ciasduhnvuerueffh634549/PCB-TESI-ODINO/PCB/distinta PCB v3-TESI.xlsx

Riferimento | Qtà | Descrizione | Package | Produttore | MPN (Part Number) | Mouser Part Number
U5 | 1 | ADC 16-Bit Bipolare (SAR) | LQFP-64 | Analog Devices | AD7606BSTZ | 584-AD7606BSTZ
U6, U11, U12, U13 | 4 | Quad Op-Amp (250 MHz) | SSOP-16 | Texas Instruments | OPA4350EA/250 | 595-OPA4350EA/250
U1 | 1 | DC/DC Invertente | TSOT-23-6 | Analog Devices | LT3483AES6#TRMPBF | 584-LT3483AES6TRMPBF
U2 | 1 | LDO +2.5V (100mA) | TSOT-23-5 | Analog Devices | LT1761ES5-2.5#TRMPBF | 584-LT1761ES5-2.5TRM
U3 | 1 | LDO Negativo | TSOT-23-5 | Analog Devices | LT1964ES5-BYP#TRMPBF | 584-LT1964ES5-BYPTRM
D1 | 1 | Diodo Schottky 30V 0.5A | SOD-323 | Diodes Inc. | BAT760-7 | 621-BAT760-7
D2, D3 | 2 | LED SMD Verde | 603 | Würth Elektronik | 150060VS75000 | 710-150060VS75000
R3 | 1 | 511 kΩ, 0.1% | 603 | Yageo | RT0603BRD07511KL | 603-RT0603BRD07511KL
R4 | 1 | 105 kΩ, 0.1% | 603 | Yageo | RT0603BRD07105KL | 603-RT0603BRD07105KL
R5 | 1 | 100 kΩ, 0.1% | 603 | Yageo | RT0603BRD07100KL | 603-RT0603BRD07100KL
R7, R8 | 2 | 4.7 kΩ, 0.1% | 603 | Yageo | RT0603BRD074K7L | 603-RT0603BRD074K7L
R10, R22, R27, R32... | 8 | 1 MΩ, 0.1% | 603 | Yageo | RT0603BRD071ML | 603-RT0603BRD071ML
R23, R25, R28, R30... | 14 | 5 kΩ, 0.1% | 603 | Yageo | RT0603BRD075KL | 603-RT0603BRD075KL
R24, R26, R29, R31... | 14 | 10 kΩ, 0.1% | 603 | Yageo | RT0603BRD0710KL | 603-RT0603BRD0710KL
C1 | 1 | 4.7 µF, 10V, X7R | 805 | Murata | GRM21BR71A475KA73L | 81-GRM21BR71A475KA73
C3, C4, C42, C46, C47 | 5 | 10 µF, 10V, X7R | 805 | Murata | GRM21BR71A106KE51L | 81-GRM21BR71A106KE51
C45 | 1 | 1 µF, 25V, X7R | 805 | Murata | GRM21BR71E105KA99L | 81-GRM21BR71E105K99L
C11, C22, C23, C24... | 8 | 100 nF (0.1µF), 16V, X7R | 603 | Murata | GRM188R71C104KA01D | 81-GRM188R71C104KA01
C5 | 1 | 10 nF (0.01µF), 50V, X7R | 603 | Murata | GRM188R71H103KA01D | 81-GRM188R71H103KA01
C2 | 1 | 22 pF, 50V, C0G | 603 | Murata | GRM1885C1H220JA01D | 81-GRM1885C1H220JA01
C8, C10, C12, C13... | 8 | 15 pF, 50V, C0G | 603 | Murata | GRM1885C1H150JA01D | 81-GRM1885C1H150J01D
L1 | 1 | Induttore Accoppiato 4.7 µH | SMD | Eaton | SDQ12-4R7-R | 704-SDQ12-4R7-R
J3 | 1 | Connettore FPC 10-pin | SMD | Würth | 687110182122 | 710-687110182122
J1 | 1 | Pin Header 1x02 (SMD) | SMD | Samtec | TSM-102-01-L-SV | 200-TSM10201LSV
J5 | 1 | Pin Header 1x03 (SMD) | SMD | Samtec | TSM-103-01-L-SV | 200-TSM10301LSV
J7 | 1 | Pin Header 1x07 (SMD) | SMD | Samtec | TSM-107-01-L-SV | 200-TSM10701LSV
