ciasduhnvuerueffh634549/PCB-TESI-ODINO/PCB/PCB v2.kicad_pcb

## KiCad design PCB/PCB v2.kicad_pcb (2026-09-29)

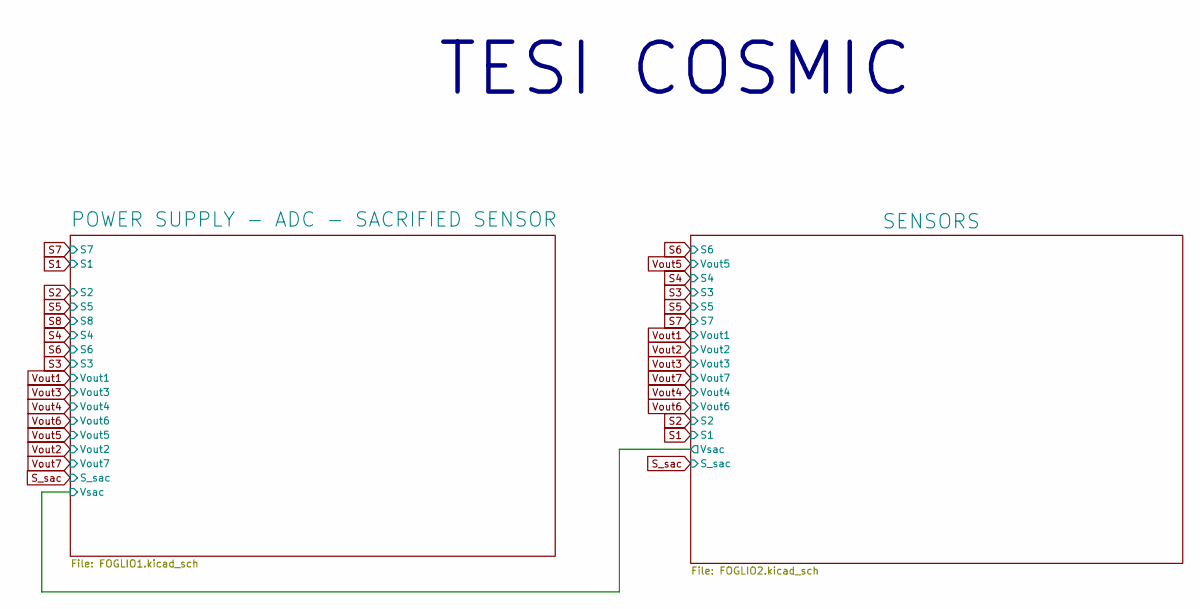
[picture p1: schematic PCB v2.kicad_sch, Tesi di laurea]

Notes on the sheet:
TESI COSMIC

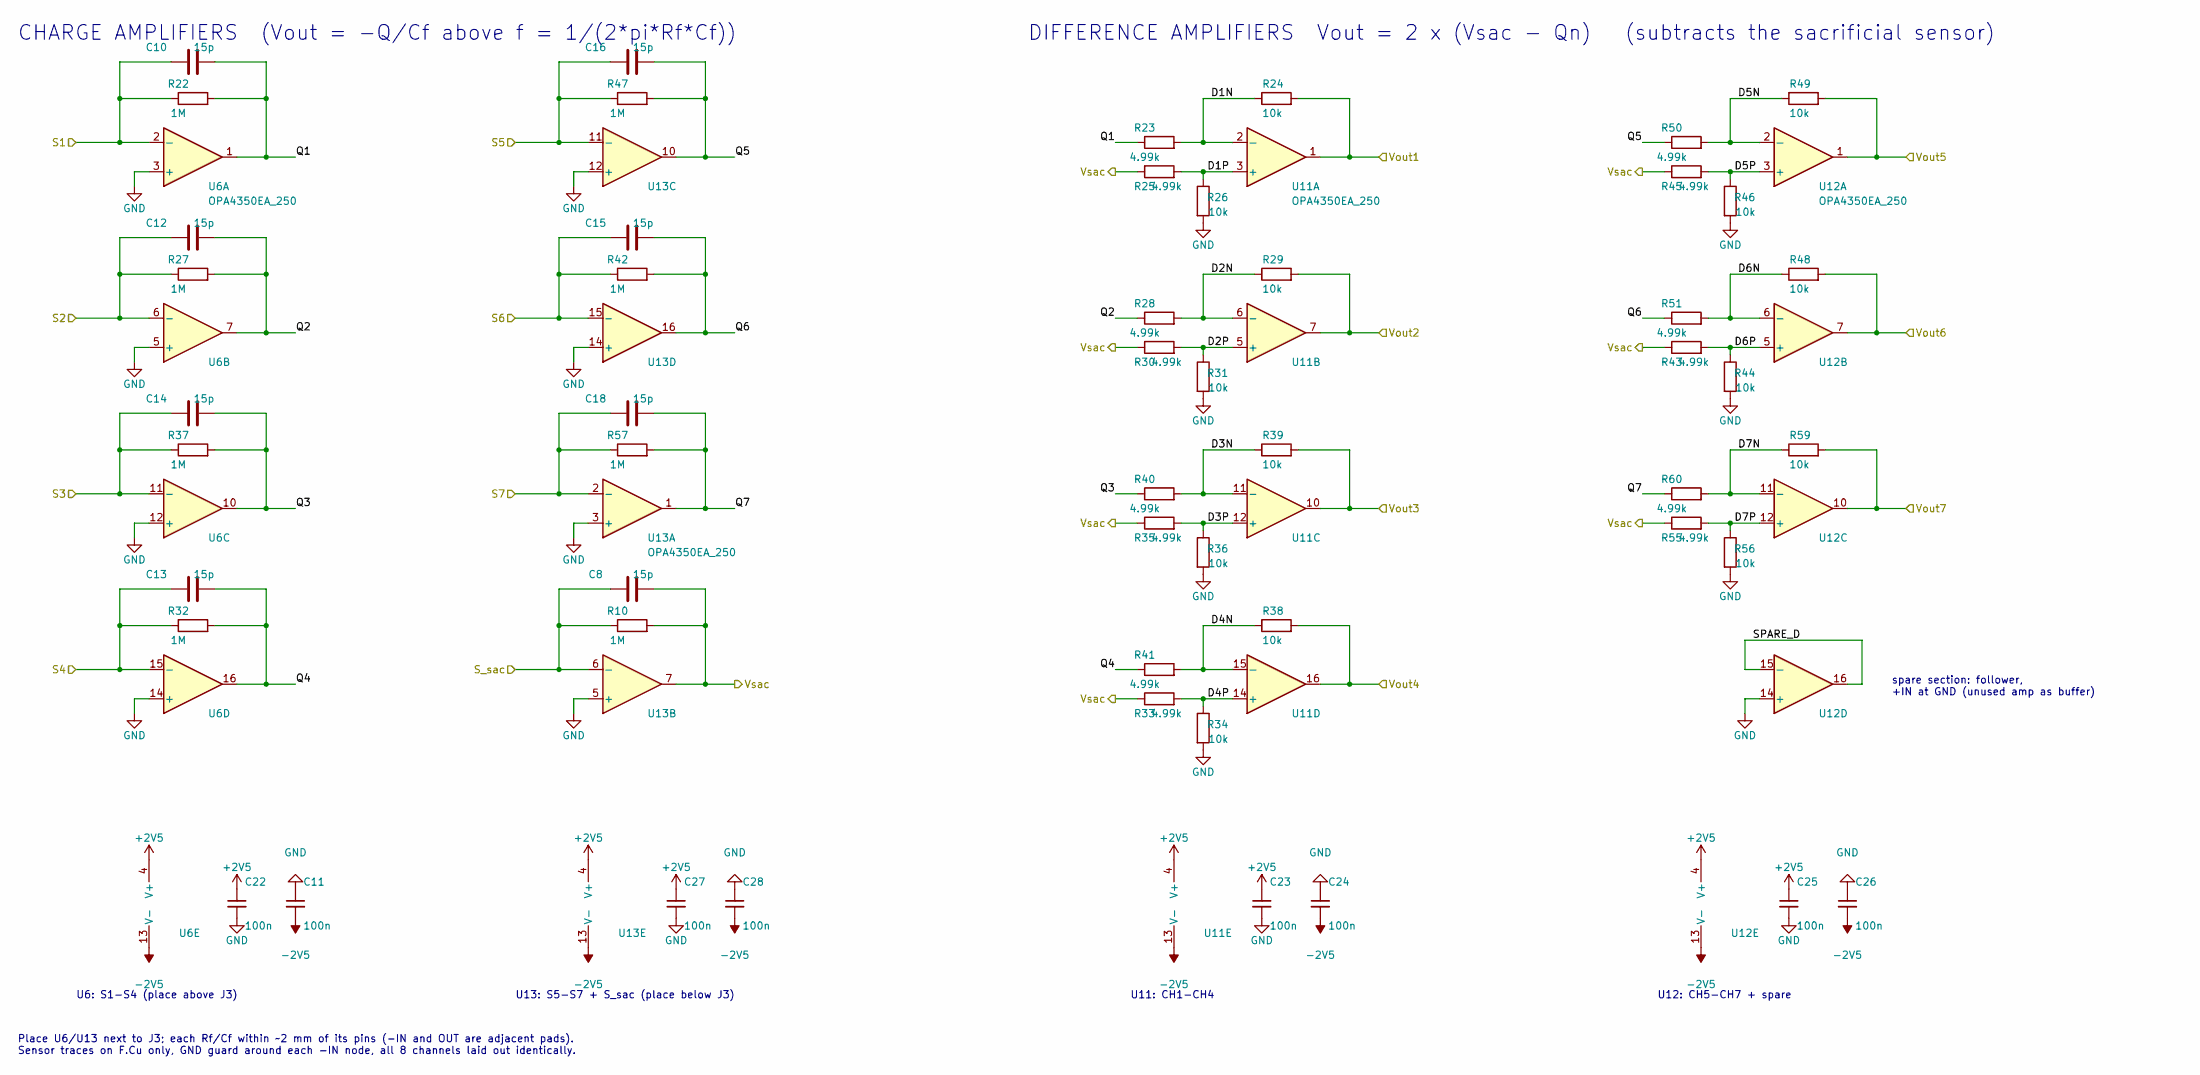
[picture p2: schematic FOGLIO2.kicad_sch]

Parts:
C8, C10, C12, C13, C14, C15, C16, C18: 15p; C_0603_1608Metric; MPN CL10C150JB8NNNC
C11, C22, C23, C24, C25, C26, C27, C28: 100n; C_0603_1608Metric; MPN GRM188R72A104KA35D
R10, R22, R27, R32, R37, R42, R47, R57: 1M; R_0603_1608Metric; MPN RN73R1JTTD1004B25
R23, R25, R28, R30, R33, R35, R40, R41, R43, R45, R50, R51, R55, R60: 4.99k; R_0603_1608Metric; MPN RT0603BRD074K99L
R24, R26, R29, R31, R34, R36, R38, R39, R44, R46, R48, R49, R56, R59: 10k; R_0603_1608Metric; MPN RT0603BRD0710KL
U6, U11, U12, U13: OPA4350EA_250; SOP63P600X175-16N; MPN OPA4350EA/250

Connections:
+2V5: C22.1, C23.1, C25.1, C27.1, U6.4 (V+), U11.4 (V+), U12.4 (V+), U13.4 (V+); also elsewhere on the board
-2V5: C11.2, C24.2, C26.2, C28.2, U6.13 (V-), U11.13 (V-), U12.13 (V-), U13.13 (V-); also elsewhere on the board
/POWER SUPPLY - ADC - SACRIFIED SENSOR/Vsac: C8.2, R10.2, R25.1, R30.1, R33.1, R35.1, R43.1, R45.1, R55.1, U13.7; also elsewhere on the board
/SENSORS/D1N: R23.2, R24.1, U11.2 (-)
/SENSORS/D1P: R25.2, R26.1, U11.3 (+)
/SENSORS/D2N: R28.2, R29.1, U11.6 (-)
/SENSORS/D2P: R30.2, R31.1, U11.5 (+)
/SENSORS/D3N: R39.1, R40.2, U11.11 (-)
/SENSORS/D3P: R35.2, R36.1, U11.12 (+)
/SENSORS/D4N: R38.1, R41.2, U11.15 (-)
/SENSORS/D4P: R33.2, R34.1, U11.14 (+)
/SENSORS/D5N: R49.1, R50.2, U12.2 (-)
/SENSORS/D5P: R45.2, R46.1, U12.3 (+)
/SENSORS/D6N: R48.1, R51.2, U12.6 (-)
/SENSORS/D6P: R43.2, R44.1, U12.5 (+)
/SENSORS/D7N: R59.1, R60.2, U12.11 (-)
/SENSORS/D7P: R55.2, R56.1, U12.12 (+)
/SENSORS/Q1: C10.2, R22.2, R23.1, U6.1
/SENSORS/Q2: C12.2, R27.2, R28.1, U6.7
/SENSORS/Q3: C14.2, R37.2, R40.1, U6.10
/SENSORS/Q4: C13.2, R32.2, R41.1, U6.16
/SENSORS/Q5: C16.2, R47.2, R50.1, U13.10
/SENSORS/Q6: C15.2, R42.2, R51.1, U13.16
/SENSORS/Q7: C18.2, R57.2, R60.1, U13.1
/SENSORS/SPARE_D: U12.15 (-), U12.16
GND: C11.1, C22.2, C23.2, C24.1, C25.2, C26.1, C27.2, C28.1, R26.2, R31.2, R34.2, R36.2, R44.2, R46.2, R56.2, U6.3 (+), U6.5 (+), U6.12 (+), U6.14 (+), U12.14 (+), U13.3 (+), U13.5 (+), U13.12 (+), U13.14 (+); also elsewhere on the board
S1: C10.1, R22.1, U6.2 (-); also elsewhere on the board
S2: C12.1, R27.1, U6.6 (-); also elsewhere on the board
S3: C14.1, R37.1, U6.11 (-); also elsewhere on the board
S4: C13.1, R32.1, U6.15 (-); also elsewhere on the board
S5: C16.1, R47.1, U13.11 (-); also elsewhere on the board
S6: C15.1, R42.1, U13.15 (-); also elsewhere on the board
S7: C18.1, R57.1, U13.2 (-); also elsewhere on the board
S_sac: C8.1, R10.1, U13.6 (-); also elsewhere on the board
Vout1: R24.2, U11.1; also elsewhere on the board
Vout2: R29.2, U11.7; also elsewhere on the board
Vout3: R39.2, U11.10; also elsewhere on the board
Vout4: R38.2, U11.16; also elsewhere on the board
Vout5: R49.2, U12.1; also elsewhere on the board
Vout6: R48.2, U12.7; also elsewhere on the board
Vout7: R59.2, U12.10; also elsewhere on the board

Notes on the sheet:
Place U6/U13 next to J3; each Rf/Cf within ~2 mm of its pins (-IN and OUT are adjacent pads). Sensor traces on F.Cu only, GND guard around each -IN node, all 8 channels laid out identically.
U12: CH5-CH7 + spare
U13: S5-S7 + S_sac (place below J3)
CHARGE AMPLIFIERS (Vout = -Q/Cf above f = 1/(2*pi*Rf*Cf))
spare section: follower, +IN at GND (unused amp as buffer)
U6: S1-S4 (place above J3)
U11: CH1-CH4
DIFFERENCE AMPLIFIERS Vout = 2 x (Vsac - Qn) (subtracts the sacrificial sensor)

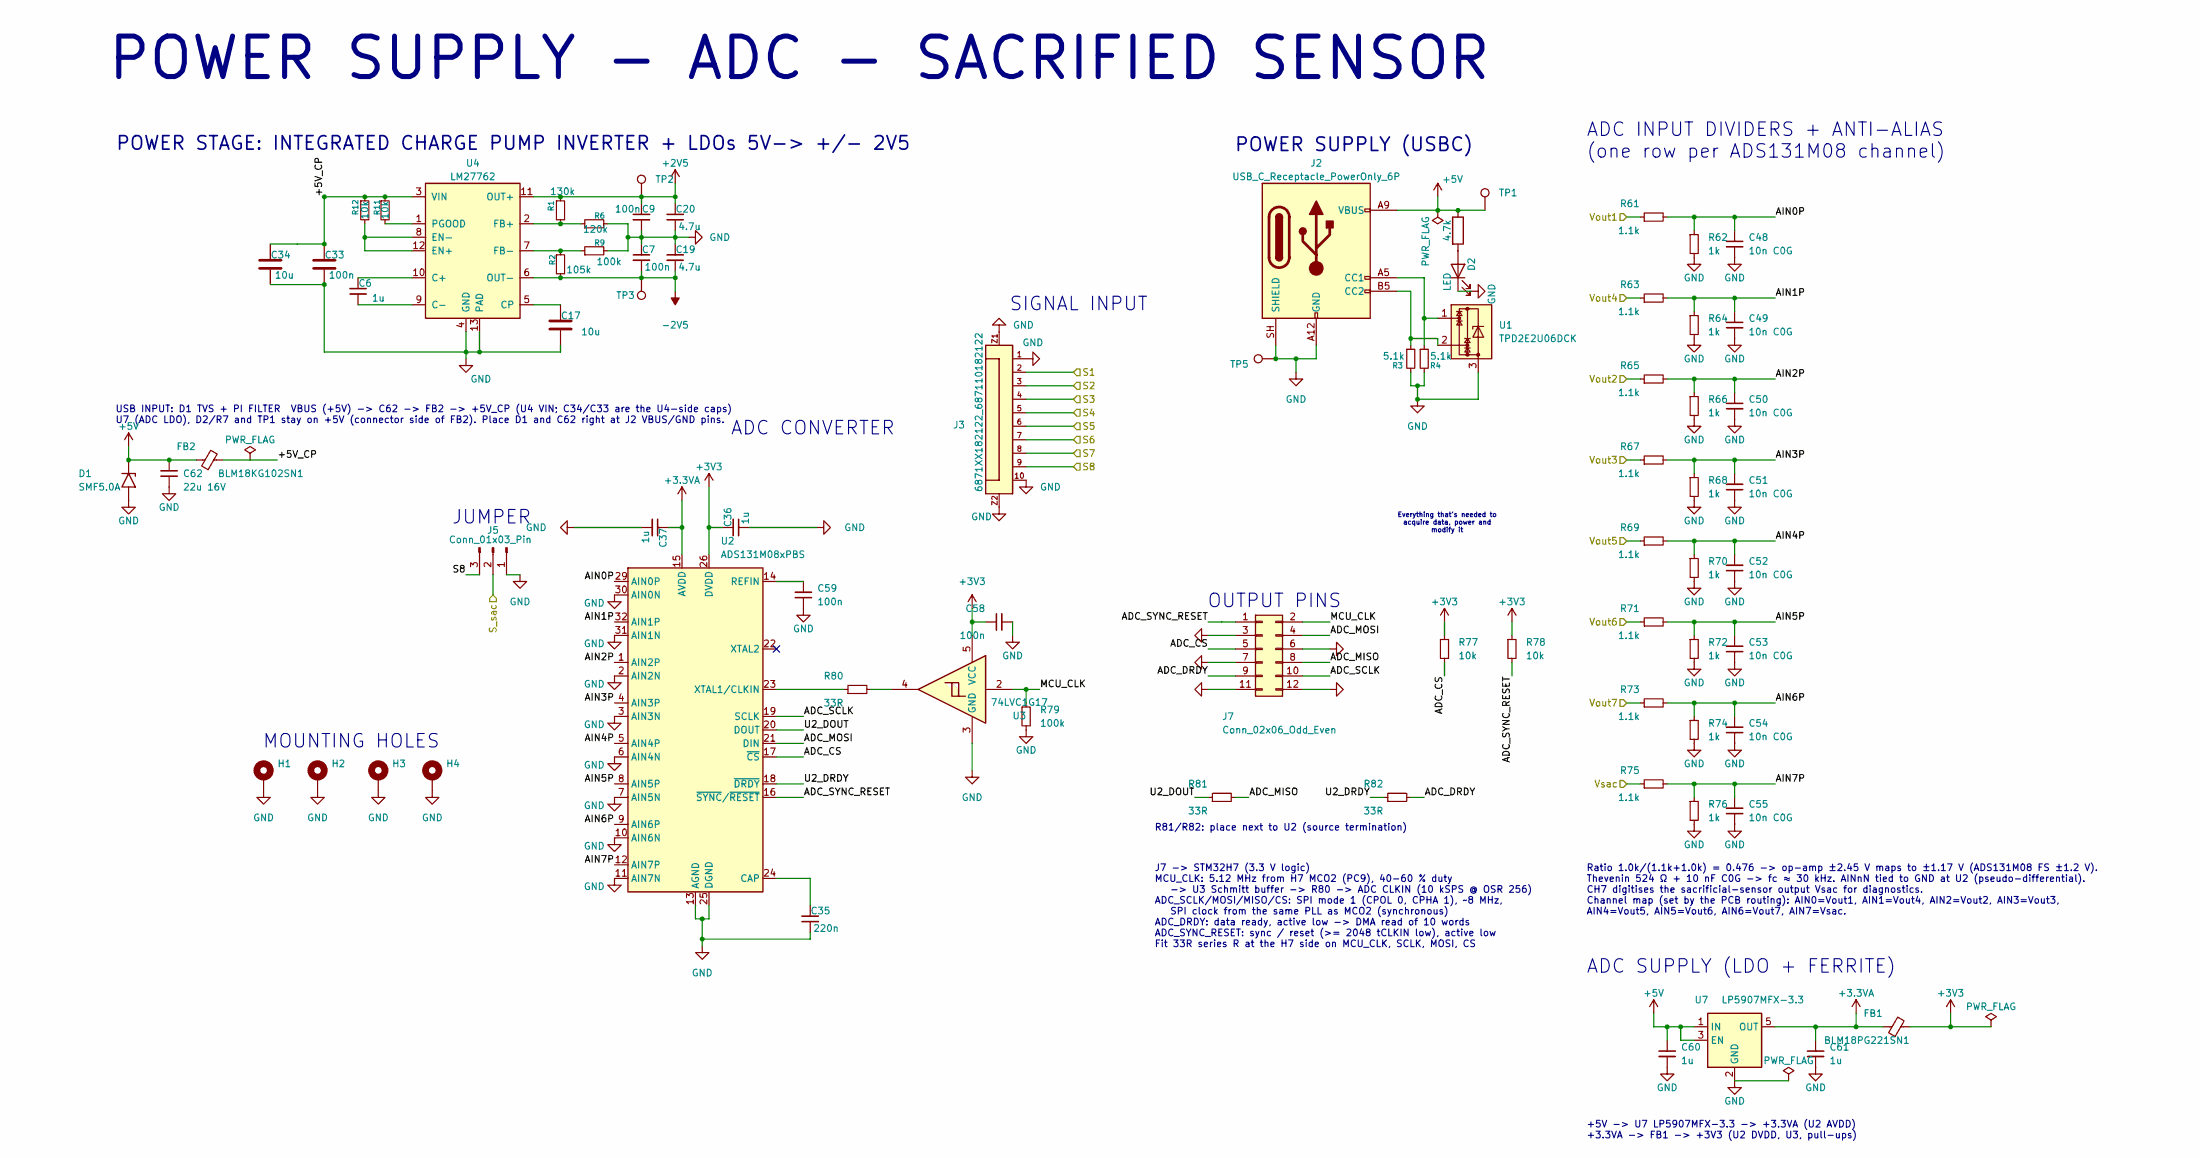
[picture p3: schematic FOGLIO1.kicad_sch]

Parts:
C6, C36, C37, C60, C61: 1u; C_0603_1608Metric; MPN GRT188R71E105KE13D
C7, C9, C33, C58, C59: 100n; C_0603_1608Metric; MPN GRM188R72A104KA35D
C17, C34: 10u; C_0805_2012Metric; MPN GRJ21BR61E106KE01L
C19, C20: 4.7u; C_0603_1608Metric; MPN GRT188R61C475KE13D
C35: 220n; C_0603_1608Metric; MPN GRM188R71E224KA88D
C48, C49, C50, C51, C52, C53, C54, C55: 10n C0G; C_0603_1608Metric; MPN GRM1885C1H103JA01D
C62: 22u 16V; C_0805_2012Metric; MPN GRM219R61C226ME15K
D1: SMF5.0A; D_SMF; MPN SMF5.0A
D2: LED; LED_0603_1608Metric; MPN 150060GS75000
FB1: BLM18PG221SN1; L_0603_1608Metric; MPN BLM18PG221SN1D
FB2: BLM18KG102SN1; L_0603_1608Metric; MPN BLM18KG102SN1D
H1, H2, H3, H4: MountingHole_Pad; MountingHole_2.2mm_M2_DIN965_Pad
J2: USB_C_Receptacle_PowerOnly_6P; USB_C_Receptacle_GCT_USB4125-xx-x_6P_TopMnt_Horizontal; MPN USB4125-GF-A
J3: 6871XX182122_687110182122; 687110182122; MPN 687110182122
J5: Conn_01x03_Pin; PinHeader_1x03_P1.27mm_Vertical_SMD_Pin1Right; MPN M50-3630342
J7: Conn_02x06_Odd_Even; PinHeader_2x06_P2.54mm_Vertical_SMD; MPN 61001221121
R1: 130k; R_0603_1608Metric; MPN RC0603FR-07130KL
R2: 105k; R_0603_1608Metric; MPN AC0603FR-07105KL
R3, R4: 5.1k; R_0603_1608Metric; MPN RC0603FR-075K1L
R6: 120k; R_0603_1608Metric; MPN RC0603FR-07120KL
R7: 4.7k; R_0603_1608Metric; MPN RC0603FR-074K7L
R9, R79: 100k; R_0603_1608Metric; MPN RC0603FR-07100KL
R11, R12, R77, R78: 10k; R_0603_1608Metric; MPN RC0603FR-0710KL
R61, R63, R65, R67, R69, R71, R73, R75: 1.1k; R_0603_1608Metric; MPN RT0603BRD071K1L
R62, R64, R66, R68, R70, R72, R74, R76: 1k; R_0603_1608Metric; MPN RN73R1JTTD1001B25
R80, R81, R82: 33R; R_0603_1608Metric; MPN RC0603FR-0733RL
TP1, TP2, TP3, TP5: TestPoint; TestPoint_Pad_D1.5mm
U1: TPD2E2U06DCK; SOT-323_SC-70; MPN TPD2E2U06DCKR
U2: ADS131M08xPBS; TQFP-32_5x5mm_P0.5mm; MPN ADS131M08IPBSR
U3: 74LVC1G17; SOT-23-5; MPN SN74LVC1G17DBVR
U4: LM27762; WSON-12-1EP_3x2mm_P0.5mm_EP1x2.65_ThermalVias; MPN LM27762DSSR
U7: LP5907MFX-3.3; SOT-23-5; MPN LP5907MFX-3.3/NOPB

Connections:
+2V5: C9.1, C20.1, R1.1, TP2.1 (1_1), U4.11 (OUT+); also elsewhere on the board
+3.3VA: C37.1, C61.1, FB1.1, U2.15 (AVDD), U7.5 (OUT)
+3V3: C36.1, C58.1, FB1.2, R77.1, R78.1, U2.26 (DVDD), U3.5 (VCC)
+5V: C60.1, C62.1, D1.1 (A1), FB2.1, J2.A9 (VBUS), J2.B9 (VBUS), R7.1, TP1.1 (1_1), U7.1 (IN), U7.3 (EN)
-2V5: C7.2, C19.2, R2.2, TP3.1 (1_1), U4.6 (OUT-); also elsewhere on the board
/POWER SUPPLY - ADC - SACRIFIED SENSOR/+5V_CP: C33.1, C34.1, FB2.2, R11.1, R12.1, U4.3 (VIN)
/POWER SUPPLY - ADC - SACRIFIED SENSOR/ADC_CS: J7.5, R77.2, U2.17 (~CS)
/POWER SUPPLY - ADC - SACRIFIED SENSOR/ADC_DRDY: J7.9, R82.2
/POWER SUPPLY - ADC - SACRIFIED SENSOR/ADC_MISO: J7.8, R81.2
/POWER SUPPLY - ADC - SACRIFIED SENSOR/ADC_MOSI: J7.4, U2.21 (DIN)
/POWER SUPPLY - ADC - SACRIFIED SENSOR/ADC_SCLK: J7.10, U2.19 (SCLK)
/POWER SUPPLY - ADC - SACRIFIED SENSOR/ADC_SYNC_RESET: J7.1, R78.2, U2.16 (~SYNC/~RESET)
/POWER SUPPLY - ADC - SACRIFIED SENSOR/AIN0P: C48.1, R61.2, R62.1, U2.29 (AIN0P)
/POWER SUPPLY - ADC - SACRIFIED SENSOR/AIN1P: C49.1, R63.2, R64.1, U2.32 (AIN1P)
/POWER SUPPLY - ADC - SACRIFIED SENSOR/AIN2P: C50.1, R65.2, R66.1, U2.1 (AIN2P)
/POWER SUPPLY - ADC - SACRIFIED SENSOR/AIN3P: C51.1, R67.2, R68.1, U2.4 (AIN3P)
/POWER SUPPLY - ADC - SACRIFIED SENSOR/AIN4P: C52.1, R69.2, R70.1, U2.5 (AIN4P)
/POWER SUPPLY - ADC - SACRIFIED SENSOR/AIN5P: C53.1, R71.2, R72.1, U2.8 (AIN5P)
/POWER SUPPLY - ADC - SACRIFIED SENSOR/AIN6P: C54.1, R73.2, R74.1, U2.9 (AIN6P)
/POWER SUPPLY - ADC - SACRIFIED SENSOR/AIN7P: C55.1, R75.2, R76.1, U2.12 (AIN7P)
/POWER SUPPLY - ADC - SACRIFIED SENSOR/MCU_CLK: J7.2, R79.1, U3.2
/POWER SUPPLY - ADC - SACRIFIED SENSOR/U2_DOUT: R81.1, U2.20 (DOUT)
/POWER SUPPLY - ADC - SACRIFIED SENSOR/U2_DRDY: R82.1, U2.18 (~DRDY)
/POWER SUPPLY - ADC - SACRIFIED SENSOR/Vsac: R75.1; also elsewhere on the board
GND: C7.1, C9.2, C17.2, C19.1, C20.2, C33.2, C34.2, C35.2, C36.2, C37.2, C48.2, C49.2, C50.2, C51.2, C52.2, C53.2, C54.2, C55.2, C58.2, C59.2, C60.2, C61.2, C62.2, D1.2 (A2), D2.1 (K), H1.1 (1_1), H2.1 (1_1), H3.1 (1_1), H4.1 (1_1), J2.A12 (GND), J2.B12 (GND), J2.SH (SHIELD), J3.1, J3.10, J3.Z1, J3.Z2, J5.1, J7.3, J7.6, J7.7, J7.11, J7.12, R3.2, R4.2, R6.2, R9.2, R62.2, R64.2, R66.2, R68.2, R70.2, R72.2, R74.2, R76.2, R79.2, TP5.1 (1_1), U1.3, U2.2 (AIN2N), U2.3 (AIN3N), U2.6 (AIN4N), U2.7 (AIN5N), U2.10 (AIN6N), U2.11 (AIN7N), U2.13 (AGND), U2.25 (DGND), U2.27 (AGND), U2.28 (AGND), U2.30 (AIN0N), U2.31 (AIN1N), U3.3 (GND), U4.4 (GND), U4.13 (PAD), U7.2 (GND); also elsewhere on the board
unnamed: D2.2 (A), R7.2
unnamed: J2.A5 (CC1), R4.1, U1.1
unnamed: J2.B5 (CC2), R3.1, U1.2
unnamed: R80.2, U3.4
unnamed: C35.1, U2.24 (CAP)
unnamed: C59.1, U2.14 (REFIN)
unnamed: R80.1, U2.23 (XTAL1/CLKIN)
unnamed: C6.1, U4.10 (C+)
unnamed: C6.2, U4.9 (C-)
unnamed: C17.1, U4.5 (CP)
unnamed: R12.2, U4.8 (EN-), U4.12 (EN+)
unnamed: R1.2, R6.1, U4.2 (FB+)
unnamed: R2.1, R9.1, U4.7 (FB-)
unnamed: R11.2, U4.1 (PGOOD)
S1: J3.2; also elsewhere on the board
S2: J3.3; also elsewhere on the board
S3: J3.4; also elsewhere on the board
S4: J3.5; also elsewhere on the board
S5: J3.6; also elsewhere on the board
S6: J3.7; also elsewhere on the board
S7: J3.8; also elsewhere on the board
S8: J3.9, J5.3
S_sac: J5.2; also elsewhere on the board
Vout1: R61.1; also elsewhere on the board
Vout2: R65.1; also elsewhere on the board
Vout3: R67.1; also elsewhere on the board
Vout4: R63.1; also elsewhere on the board
Vout5: R69.1; also elsewhere on the board
Vout6: R71.1; also elsewhere on the board
Vout7: R73.1; also elsewhere on the board

Notes on the sheet:
SIGNAL INPUT
MOUNTING HOLES
POWER STAGE: INTEGRATED CHARGE PUMP INVERTER + LDOs 5V-> +/- 2V5
ADC INPUT DIVIDERS + ANTI-ALIAS (one row per ADS131M08 channel)
ADC CONVERTER
ADC SUPPLY (LDO + FERRITE)
J7 -> STM32H7 (3.3 V logic) MCU_CLK: 5.12 MHz from H7 MCO2 (PC9), 40-60 % duty -> U3 Schmitt buffer -> R80 -> ADC CLKIN (10 kSPS @ OSR 256) ADC_SCLK/MOSI/MISO/CS: SPI mode 1 (CPOL 0, CPHA 1), ~8 MHz, SPI clock from the same PLL as MCO2 (synchronous) ADC_DRDY: data ready, active low -> DMA read of 1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
R81/R82: place next to U2 (source termination)
Ratio 1.0k/(1.1k+1.0k) = 0.476 -> op-amp ±2.45 V maps to ±1.17 V (ADS131M08 FS ±1.2 V). Thevenin 524 Ω + 10 nF C0G -> fc ≈ 30 kHz. AINnN tied to GND at U2 (pseudo-differential). CH7 digitises the sacrificial-sensor output Vsac for diagnostics. Channel map (set by the PCB routing): AIN0=Vout1, AIN1=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
Everything that's needed to acquire data, power and modify it
POWER SUPPLY (USBC)
POWER SUPPLY - ADC - SACRIFIED SENSOR
OUTPUT PINS
JUMPER
+5V -> U7 LP5907MFX-3.3 -> +3.3VA (U2 AVDD) +3.3VA -> FB1 -> +3V3 (U2 DVDD, U3, pull-ups)
USB INPUT: D1 TVS + PI FILTER VBUS (+5V) -> C62 -> FB2 -> +5V_CP (U4 VIN; C34/C33 are the U4-side caps) U7 (ADC LDO), D2/R7 and TP1 stay on +5V (connector side of FB2). Place D1 and C62 right at J2 VBUS/GND pins.

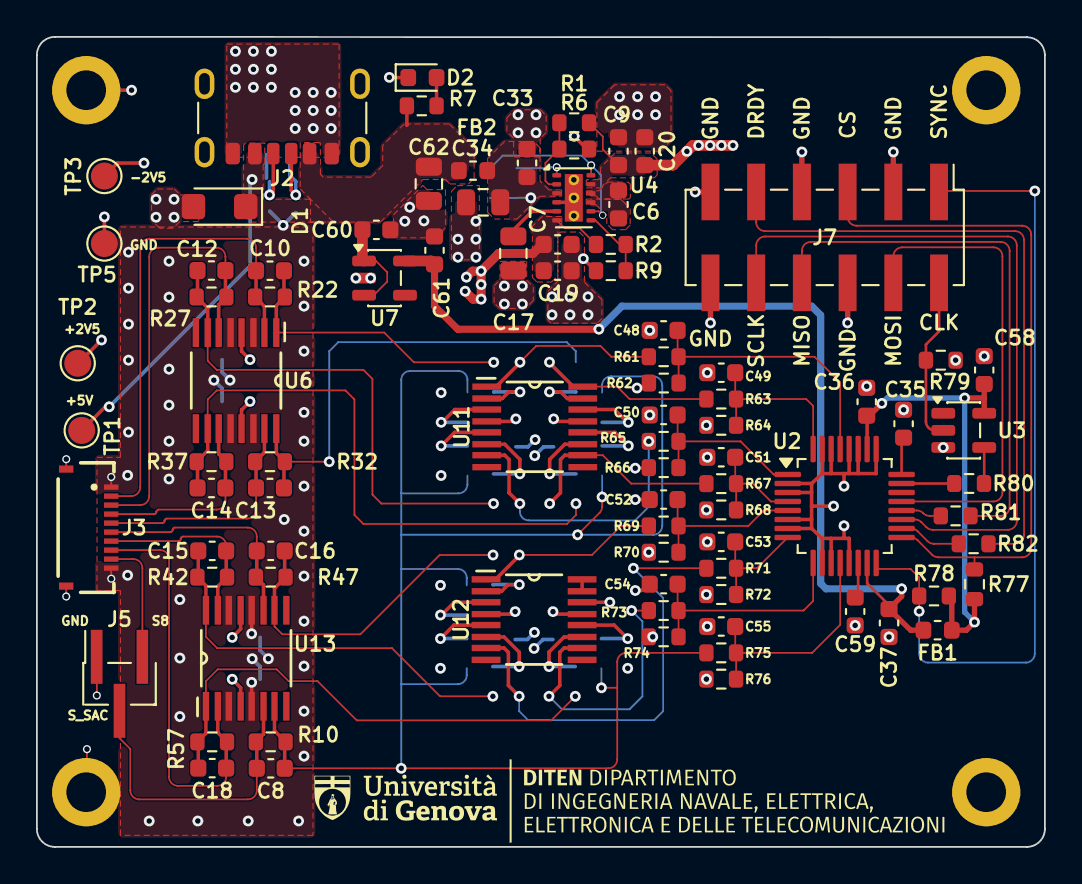
[picture p4: board PCB v2.kicad_pcb from above]

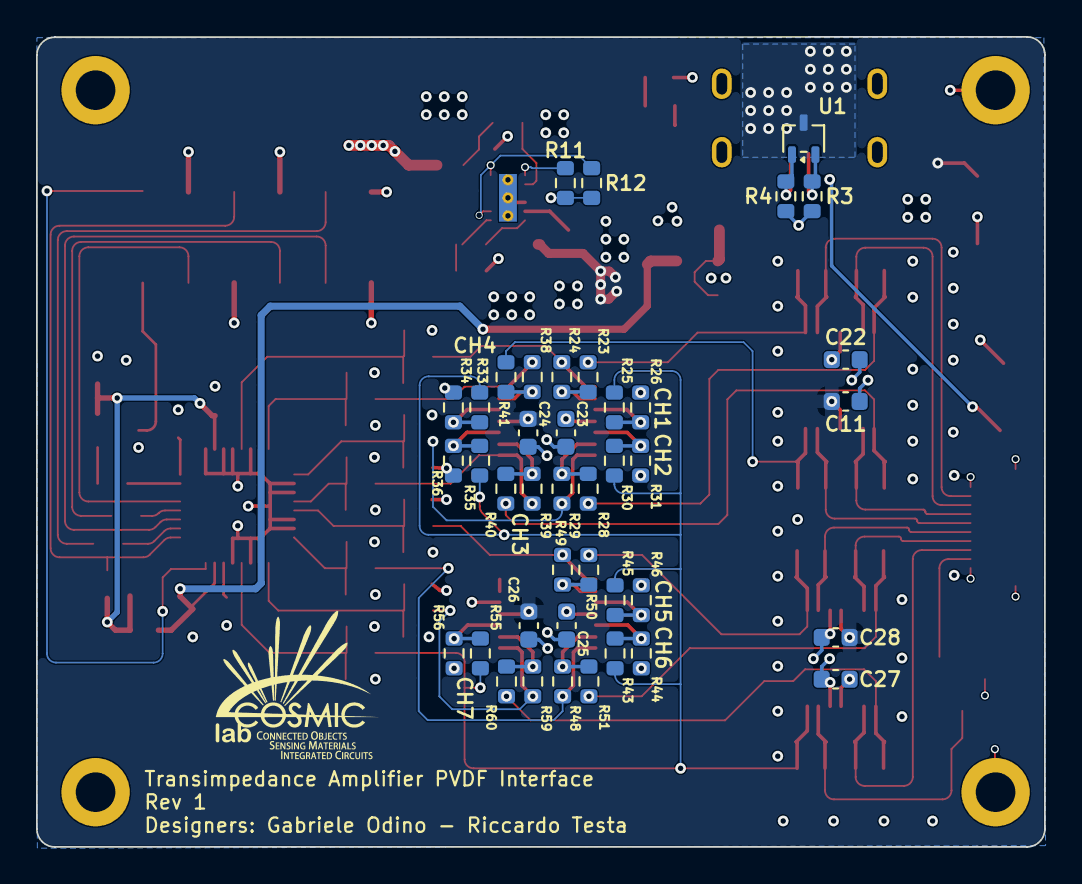
[picture p5: board PCB v2.kicad_pcb from below]

Board: 4 copper layers, 56.0 x 45.0 mm, 132 parts (41 on the bottom side), 77 nets.
