ciasduhnvuerueffh634549/PCB-TESI-ODINO/(commit log)

2026-09-15 Primo rilascio
    [FOGLIO1.kicad_sch, FOGLIO2.kicad_sch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]
2026-09-15 Eseguite modifiche
    [PCB v2.kicad_pcb]
2026-09-15 Riorganizzato il progetto nella cartella PCB
    [FOGLIO1.kicad_sch, FOGLIO2.kicad_sch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]
2026-09-16 Carico distinta materiali con PN MOUSER
    [PCB v2.csv, distinta PCB v3-TESI.xlsx]
2026-09-18 Prime modifiche
    [PCB v2.kicad_pcb]
2026-09-18 Modifiche accordate fatte
    [FOGLIO1.kicad_sch, FOGLIO2.kicad_sch, PCB v2.kicad_pcb, PCB v2.kicad_sch]
2026-09-21 Added decoupling caps to LDOs, started reworking the power SMPS layout
    [PCB v2.kicad_pcb]
2026-09-22 Added decoupling on LDOs, continued optimized power layout, changed packages of 1uF caps
    [FOGLIO1.kicad_sch, PCB v2.kicad_pcb]
2026-09-28 Changed power, started changing ADC and refactoring signal amplitude
    [FOGLIO1.kicad_sch, PCB v2.kicad_pcb]
2026-09-28 Swap AD7606 for ADS131M08, rework analog front-end and USB input
    Schematic-only changes; the PCB has not been updated from the schematic
    yet. PCB/CHANGELOG-2026-09-28-ADC-swap.md has the per-part details: every
    added/removed part with its pin-to-net list, the netlist diff (before ->
    after) and the ERC counts.
    1. ADC swap (FOGLIO1)
    - Remove the AD7606 (U5) and parts that only served it: C29-C32, C45-C47,
    BUSY LED D3/R8 and the old 1x07 J7.
    - Wire up the ADS131M08 (U2): internal 1.2 V reference with 100n on REFIN,
    XTAL2 no-connect, AINxN tied to GND.
    - Per-channel divider + anti-alias RC (R61-R76 1.1k/1k, C48-C55 10n C0G):
    op-amp swing +-2.45 V -> +-1.17 V for the +-1.2 V ADC full scale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
    [FOGLIO1.kicad_sch, FOGLIO2.kicad_sch, PCB v2.kicad_sch]
2026-09-28 Add KiCad .gitignore and stop tracking local/generated files
    - New root .gitignore for KiCad: lock files, autosaves, editor backups,
    automatic project backup folders (*-backups/), fp-info-cache,
    netlist/autorouter exchange files and the per-user *.kicad_prl.
    BOM exports (*.csv/*.xml) are deliberately not ignored because the
    repo tracks "PCB v2.csv".
    - Untrack (files stay on disk and in history):
    - PCB/~PCB v2.kicad_pro.lck (KiCad lock file)
    - PCB/PCB v2.kicad_prl (per-user view state)
    - 113 backup zips in PCB/TESI-backups and PCB/PCB v2-backups
    Claude-Session: https://claude.ai/code/session_01FkMyFfAWNWvsXoQ2tBz5gZ
2026-09-28 Add MPNs to all parts, switch unavailable parts, add Mouser BOM
    Schematic procurement pass, based on a Mouser Italia stock/price check
    (2026-09-28). The netlist is unchanged and ERC is still at 0 errors.
    Details are in PCB/CHANGELOG-2026-09-28-ADC-swap.md, Part 5.
    Schematic (FOGLIO1, FOGLIO2):
    - Every orderable part (123) now has MPN and Manufacturer fields. The
    old SnapEDA "MF" field on the op-amps is replaced by Manufacturer.
    - Difference-amp resistors 5k -> 4.99k (R23, R25, R28, R30, R33, R35,
    R40, R41, R43, R45, R50, R51, R55, R60). Exact 5.0k only exists at
    0.1 %/25 ppm for about EUR 1.7. Both halves of each difference amp use
    the same 4.99k/10k pair, so the ratio still matches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
    [BOM_Mouser_2026-09-28.csv, FOGLIO1.kicad_sch, FOGLIO2.kicad_sch]
2026-09-28 Lay out the analog front-end: op-amp groups, sensor inputs, GND guard
    Board work since d215e9c. The schematic changes were brought in with
    Update PCB from Schematic; op-amp placement and some routing were done
    by hand in pcbnew; the rest was scripted through the KiCad IPC API and
    checked with offline DRC.
    Op-amp groups (TIA and difference amps):
    - U6: its Rf/Cf pairs sit right at each section's -IN/OUT pads, with the
    +2V5/-2V5 decoupling caps (C22/C11) on the bottom under the chip.
    - U13: U6's placement, fan-out tracks and vias copied exactly
    (40 segments, 4 vias). Section mapping is A->A (S1->S7), B->B
    (S2->S_sac), C->C (S3->S5), D->D (S4->S6); C27/C28 are on the bottom.
    - U11: the l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
    [PCB v2.kicad_pcb]
2026-09-28 Move J5 (sacrificial-sensor select header) to 1.27 mm pitch
    J5 (Conn_01x03_Pin: 1 GND, 2 S_sac, 3 S8) selects what drives the
    sacrificial-sensor channel. With a jumper, S_sac ties to S8 (the eighth
    sensor line from J3) or to GND. At 2.54 mm pitch the header did not fit
    next to U13 inside the analog guard, so it moves to the 1.27 mm
    equivalent of the same style.
    Schematic (FOGLIO1):
    - J5 footprint:
    Connector_PinHeader_2.54mm:PinHeader_1x03_P2.54mm_Vertical_SMD_Pin1Right
    -> Connector_PinHeader_1.27mm:PinHeader_1x03_P1.27mm_Vertical_SMD_Pin1Right
    - Same alternating "pin 1 right" arrangement, so pin 2 stays on the
    opposite side from pins 1 and 3.
    - Pads are 3.0 x 0.65 mm at +/-1.5 mm, 1.2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
    [BOM_Mouser_2026-09-28.csv, FOGLIO1.kicad_sch]
2026-09-28 Place 1.27 mm J5 next to U13 and route S8 / S_sac inside the GND guard
    J5 footprint update (from the schematic change) and placement:
    - J5 is now the 1.27 mm SMD header, at (125.85, 111.98), rotated 90
    degrees. It sits left of U13, between J3 and mounting hole H3, inside
    the board outline.
    - Pin 1 (GND) keeps its own GND via, moved to (124.59, 112.63) with a
    short stub to the pad; this replaces the old via at (123.04, 114.94).
    S8, J3 pin 9 -> J5 pin 3 (F.Cu, 0.1 mm):
    - Leaves J3 pin 9 horizontally at y 105.05, between S7 (J3 pin 8) and
    J3 pin 10 (GND), with 0.4 / 0.3 mm gaps.
    - Turns down with a 0.5 mm radius arc and runs straight at x 127.12 into
    J5 pin 3.
    - The whole trace stays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
    [PCB v2.kicad_pcb]
2026-09-29 Choose J5 header (Harwin M50-3630342) and shunt (M50-2000005)
    J5 (sacrificial-sensor select: S_sac to S8 or GND) moved to the 1.27 mm
    PinHeader_1x03_P1.27mm_Vertical_SMD_Pin1Right footprint in d276d8f, but
    no part number had been chosen for it yet.
    Header: Harwin M50-3630342 (Archer M50, 1x03, 1.27 mm, vertical SMT;
    Mouser 855-M50-3630342).
    - Tails alternate sides.
    - The datasheet land pattern (DRG-02647) is 0.65 x 3.00 mm pads, 6.00 mm
    span, 1.27 mm pitch, which matches the KiCad footprint exactly.
    - The part has no pin-1 marking. With 3 pins, a 180 degree turn only
    swaps pins 1 and 3, so either way round fits.
    - M50-3530342 is the through-hole version and must not be ordered.
    Shunt: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
    [BOM_Mouser_2026-09-28.csv, FOGLIO1.kicad_sch]
2026-09-29 Route charge-amp outputs Q1-Q7 to the difference amplifiers
    Each first-stage output Qn feeds its diff-amp input resistor, which sits
    on B.Cu under U11 (channels 1-4) or U12 (channels 5-7).
    Q1 and Q5-Q7 (routed in pcbnew, 0.1 mm):
    - Q1 runs on F.Cu from U6 pin 1 and ends in a via-in-pad at R23.
    - Q5-Q7 run from U13 through its centre channel, between the pin rows.
    - Q5/Q6/Q7 end in vias at R50/R51/R60.
    Q2-Q4 (0.1 mm, same style):
    - Q2 and Q3 sit on the left of U6 and are closed off on F.Cu: S1/S2 run
    over the top of U6 and S3/S4 come up from below. So they leave through
    U6's centre channel instead:
    - Q2 at y 94.54, above the two GND vias; Q3 at y 95.68, below them.
    - Guard copper fi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
    [PCB v2.kicad_pcb]
2026-09-29 Place U2, J7 and the ADC input dividers in a staggered two-column block
    Placed in pcbnew:
    - U2 (ADS131M08) at (166.74, 102.07).
    - J7 (MCU header) at (165.03, 87.18), rotated -90.
    - The Vout1 divider group, a vertical stack of C48 / R61 / R62 at
    x 156.08:
    - the 10 nF and the 1 kOhm to GND tie to the 1.1 kOhm's AIN pad;
    - the Vout pad sits between the two GND pads;
    - Vout1 is routed from U11, and the AIN0P spine is in place.
    The other seven groups (R63-R76, C49-C55) copy that group shape exactly.
    Eight 3.9 mm stacks in one column would need about 35 mm, and only
    about 28 mm is free between J7 and the bottom edge. So they sit in two
    columns, staggered by half a pitch:
    - Column A at x 1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
    [PCB v2.kicad_pcb]
2026-09-29 Route the ADC fan-in and Vout5-Vout7 to their dividers
    AIN0P-AIN7P fan-in (routed in pcbnew, 0.1 mm, F.Cu):
    - Each group's AIN spine runs to its U2 pin with no crossings.
    - AIN0/1 go to the top pins, AIN2-5 to the left side, AIN6/7 to the
    bottom.
    U12 outputs (0.1 mm; the mapping matches the schematic):
    - Vout5 -> R69 (AIN4): F.Cu from its via at U12's top-left, over the top
    of U12, into the group. No new via.
    - Vout6 -> R71 (AIN5): its via sits between Q6 and Q7, so it cannot
    escape on F.Cu.
    - It goes down on B.Cu, along y 114.0 under U12, and up at x 155.5.
    - It then comes up through a via at (154.4, 105.56) and runs on F.Cu
    through the R70/C54 gap in column A.
    - Vout7 -> R73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
    [PCB v2.kicad_pcb]
2026-09-29 Rotate AIN1-AIN3 channel mapping and route Vout2-Vout4
    Each U11 output can only leave the op-amp in one practical direction,
    and that fixes the order the Vouts arrive at the divider block. Top to
    bottom they arrive as Vout1, Vout4, Vout2, Vout3:
    - Vout4 leaves pin 16 cleanly on F.Cu at the top.
    - Vout3 can only go down and to the right from pin 10, because the D3P
    fan-out via blocks the way up.
    - Vout2 is boxed in by the Q2/Q3 vias and must use B.Cu.
    Keeping the old mapping would have cost 3-4 extra vias plus a 0.65 mm
    squeeze that crosses an AIN line. The firmware has not been written yet,
    so the rotation only costs a lookup table there.
    Schematic (FOGLIO1): the three hierarchical label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
    [FOGLIO1.kicad_sch, PCB v2.kicad_pcb]
2026-09-29 Route the Vsac bus to the diff-amp +IN legs and the AIN7 divider
    Vsac, the sacrificial-sensor charge-amp output (U13 section B), is the
    reference each difference amplifier subtracts: Vout = 2*(Vsac - Qn).
    It feeds seven +IN legs (R25/R30/R33/R35 on U11, R43/R45/R55 on U12;
    4.99k + 10k to GND each) and the R75/R76/C55 divider to AIN7. That is
    about 1.07 kOhm in total, roughly 2.3 mA at full scale.
    Tap point: C8 pin 2. The net runs pin 7 -> R10 pin 2 -> C8 pin 2, and
    the op-amp regulates its output where R10/C8 tie in. Tapping at C8 keeps
    the bus current's IR drop inside the feedback loop, and it is also the
    side the route leaves the guard on.
    Route (0.1 mm, 4 vias):
    - F.Cu: from C8 pin 2 al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
    [PCB v2.kicad_pcb]
2026-09-29 Ground the analog front end and J7 to the In1 GND plane
    In1 is a solid GND plane. This adds 28 vias giving every GND pad in the
    analog section, and J7's GND pins, a direct path to it.
    Divider block (16 GND pads of the AIN0-7 anti-alias groups):
    - The block is packed on purpose. Column B's GND pads face the 0.75 mm
    channel between the columns, and every gap in it carries an AIN or
    Vout trace. So via-in-pad is used (board is hand-soldered, so no
    wicking concern).
    - Via in the pad: C49 R64 C51 R68 C53 R72 C55 R76 (column B), and
    C48 C50 R70 R74 (column A).
    - C52 and C54 sit over a B.Cu Vout route, so their via is just to the
    left with a short F.Cu stub.
    - R62/R34 and R66/R36 share on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
    [PCB v2.kicad_pcb]
2026-09-29 Re-pin J7 (MCU header) to match U2's digital pin order
    The clock and the six ADC digital lines enter U2 (ADS131M08) from its
    right side. From top to bottom they arrive as CLKIN (via U3/R80), DIN,
    DOUT (via R81), SCLK, DRDY (via R82) and CS, with SYNC at the bottom
    corner. With the old J7 order the F.Cu fan-out to the header crossed
    itself. Moving digital lines to B.Cu is not an option, because B.Cu
    sits over the +2V5 analog plane.
    The new order lets the lines run up the right board edge and enter J7
    from the side:
    - DIN, MISO, SCLK, DRDY and CS go through the 1.9 mm gap between the
    two pad rows. They peel off down into the bottom row or up into the
    top row in the order they arrive.
    - SY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
    [FOGLIO1.kicad_sch, PCB v2.kicad_pcb]
2026-09-29 Place and route the ADC area: clock buffer, decoupling, SPI to J7
    Board is now fully connected (DRC: 0 unconnected items).
    ADC position (moved in pcbnew): U2 at (166.13, 102.10), 0.6 mm left of
    the earlier spot, with the AIN fan-in adjusted. This widens the strip
    right of U2 to 7.0 mm.
    Placement:
    - Clock buffer group, all within x <= 174.55, leaving the strip on the
    right edge free for the digital lines:
    - U3 74LVC1G17 at (172.75, 97.9), rotated 0.
    - R79 100k clock pull-down at (171.5, 94.0).
    - C58 at (173.9, 94.55), vertical, above U3's VCC pin.
    - R80 33R at (173.05, 100.85), source termination at U3's output,
    with its CLKIN pad level with U2 pin 23.
    - U2 decoupling: C35 (CA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
    [PCB v2.kicad_pcb]
2026-09-29 Silkscreen: show footprint references at 0.8 mm, placed by their parts
    Reference designators were mostly hidden or at mixed sizes (1 mm,
    0.5 mm, one at 1.64 mm), with 64 hidden. This pass makes every
    reference that can fit legibly visible at one size.
    - Size 0.8 x 0.8 mm, stroke 0.15 mm (the board's minimum text height).
    - 72 references shown: 63 on F.SilkS, 9 on B.SilkS. The B-side ones
    are mirrored so they read correctly from the back.
    - Each label is placed automatically:
    - clear of pads (0.12 mm), vias, other footprint silk, board edge
    (0.3 mm) and the existing user texts;
    - closer to its own part than to any other part, so it is
    unambiguous which part it names;
    - prefer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
    [PCB v2.kicad_pcb]
2026-09-29 Silkscreen: label the dense blocks, add channel labels and J7 pin names
    Dense blocks: 0.5 mm references
    - All 56 references in the dense blocks are now shown at 0.5 x 0.5 mm,
    stroke 0.12 mm.
    - Divider block (front): each label sits on its part's own row. The
    left column (AIN0/2/4/6 triples) is labeled down its left side, the
    right column (AIN1/3/5/7) down its right side, so the labels read as
    two aligned lists.
    - Where a GND via sits right beside a pad, the label is allowed over
    the via's ring (vias are tented both sides) but never over the
    drill. R74 is labelled below its part.
    - Diff-amp resistors and C23-C26 (back): each label is next to its own
    part and closer to it t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
    [PCB v2.kicad_pcb]
2026-09-29 Silkscreen: fix stale power and J5 labels
    Several 0.5 mm user texts dated from an earlier layout and no longer
    matched the parts next to them.
    - TP5 (GND): the "+5V" text beside it becomes "GND", placed the way
    TP3's "-2V5" label is. The duplicate loose "GND" just below it,
    at (127.17, 90.43), is removed.
    - Removed an orphan "-5V" at (123.07, 111.74). No -5V net exists on
    this board, and the text also sat on J5 pin 1 (silk_over_copper).
    - Removed a loose "GND" at (125.72, 96.07), between TP2 and TP1. It
    labelled no test point.
    - J5: the old "S8", "S_SAC" and "GND" texts were left at the previous
    2.54 mm J5 position. They are replaced by pin labels at the 1.27 mm
    J5: GND above pi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
    [PCB v2.kicad_pcb]
2026-09-29 Schematic: correct the U7 regulator named in the power note
    The FOGLIO1 power-tree note still said "+5V -> U7 TPS7A2033 ->
    +3.3VA". U7 was changed to LP5907MFX-3.3/NOPB, which has the same
    SOT-23-5 pinout and footprint; the TPS7A2033 was out of stock with a
    26-week lead. The symbol, value, MPN and BOM already name the LP5907;
    only this text note was stale.
    The note now reads "+5V -> U7 LP5907MFX-3.3 -> +3.3VA (U2 AVDD)".
    Text-only change; ERC: 0 errors.
    Claude-Session: https://claude.ai/code/session_01TYMP7BCHvS3DvLnCv8UeQA
    [FOGLIO1.kicad_sch]
2026-09-29 Add DESIGN.md: design description and decision log for the board
    A single reference document for the thesis reviewer and for whoever
    builds, debugs or extends the board. It was written from the
    schematic, the board file, the BOM, the changelog, git history and
    the design-session notes; it states which source wins where they
    disagree.
    Contents:
    1. System overview and block diagram.
    2. Signal chain, stage by stage, with numbers computed from the
    actual part values:
    - charge amp: 1 M || 15 pF, 10.6 kHz corner;
    - difference amp: gain 2.004;
    - divider 0.476 and the 30.4 kHz anti-alias filter;
    - end-to-end scaling;
    - noise floor;
    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
2026-09-29 Fix op-amp pin-1 marking, re-place four labels, reroute TP3's -2V5 via
    Designer edits made in pcbnew after the pre-order review.
    - Opa4 footprint (U6, U11, U12, U13): the silkscreen pin-1 marker now
    sits at pin 1.
    - The notch was on the body edge, so the placed IC hid it.
    - The only visible mark was a bar beside the pin 9/10 corner, which
    read as pin 1 at the wrong end. Fitting the part 180 deg round
    would put the supplies on the inputs.
    - The embedded footprint's unit table is dropped as well.
    - This also clears both DRC silk_overlap items (R37/U6, U13/R47).
    - Re-placed the C9, C19, R1 and R6 reference labels. The review found
    them sitting on, or equidistant from, a nei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
    [PCB v2.kicad_pcb]
2026-09-29 Fab fixes: mask dams on J3/op-amps, plain TP/J5 labels, 0.2 mm vias
    From the pre-order review (FINAL_REVIEW.md, S2/S5/S7).
    Solder-mask dams (J3, U6, U11, U12, U13)
    - The pads of these imported footprints carried a local
    solder_mask_margin of 0.102 mm, a SnapEDA default.
    - On J3 (0.5 mm pitch, 0.3 mm pads) that left a -0.004 mm dam: the
    9 DRC solder_mask_bridge errors.
    - On the op-amps (0.635 mm pitch) it left 0.05 mm, below JLC's
    0.1 mm minimum, so the fab would remove the mask web between the
    pins.
    - The local margin is removed on all 76 pads, so they inherit the
    board's pad-to-mask clearance of 0.
    - Dams are now 0.20 mm (J3) and 0.25 mm (op-amps): mask stays between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
    [PCB v2.kicad_pcb]
2026-09-29 Add FINAL_REVIEW.md and the five pre-order review reports
    Five independent reviews of the board before ordering. Each ran KiCad
    10 checks on its own copy of the project.
    1. Requirements and scope.
    2. Schematic electrical correctness, against the TI datasheets.
    3. PCB manufacturability: DRC triage, JLC capabilities, zones,
    footprints and connectors.
    4. Schematic <-> PCB parity and signal/power integrity.
    5. Silkscreen, hand assembly and testability.
    Result: no design-file blocker.
    - The netlist matches the board exactly: 132 footprints, 386 pads,
    88 nets.
    - ERC shows 0 errors.
    - There are 0 clearance errors.
    - The In1 GND plane is solid under every sensitive trace.
    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
2026-09-29 Add board identification and logos, drop the back-side AIN labels
    Designer edits in pcbnew:
    - B.SilkS title block, 0.8 mm, lower back edge, reading correctly
    from the back:
    Transimpedance Amplifier PVDF Interface
    Rev 1
    Designers: Gabriele Odino - Riccardo Testa
    - F.SilkS: University of Genoa / DITEN logo along the bottom edge,
    x 136.7-171.7, y 116.2-120.8.
    - B.SilkS: COSMIC lab logo at (163.03, 112.05), next to the
    diff-amp block.
    - Both logos are board-only footprints, excluded from the BOM and
    position files. They have no copper, touch no pad and no via hole,
    and give no schematic-parity entry.
    - Removed the eight back-side AIN0-AIN7 labels. On the back they did
    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
    [PCB v2.kicad_pcb]
2026-09-29 Add JLCPCB production files for the Rev 1 order
    Generated in pcbnew with the Fabrication Toolkit plugin, from board
    state a8a5de7 (KiCad 10.0.6, 2026-09-29 16:28).
    production/PCB_v2.zip (upload this to JLCPCB):
    - Copper: F_Cu, In1_Cu, In2_Cu, B_Cu (4 layers).
    - F/B Mask, F/B Silkscreen, F/B Paste, Edge_Cuts.
    - PTH/NPTH Excellon drill files and drill maps.
    Checked against the board:
    - Outline 56.0 x 45.0 mm.
    - PTH hits match the board:
    - T1 0.2 mm x 9 (the resized J3/J5 GND vias and the U4 vias);
    - T2 0.3 mm x 205 vias;
    - T3 0.3 mm x 3 (U4 thermal pad);
    - T5 2.2 mm x 4 (H1-H4);
    - T4: routed 0.6 mm slots for the J2 USB-C shell.
    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
    [bom.csv, designators.csv, positions.csv]
2026-09-29 Move all vias to the 0.3 mm hole class and regenerate production files
    JLC prices vias by the smallest hole/diameter class. With every via
    at a 0.3 mm hole or larger, the board fits the cheapest one:
    "0.3mm/(0.4/0.45mm)".
    Vias
    - Eight 0.3/0.2 mm vias become 0.45/0.3 mm:
    - six GND vias next to J3 and J5: (122.89, 99.50), (125.389, 100.49),
    (125.39, 106.14), (122.89, 107.13), (124.59, 112.63),
    (124.04, 115.61);
    - U4 PGOOD (150.14, 83.28);
    - U4 pin-12 EN+ (152.05, 83.17).
    - U4 pin-8 EN+ via: 0.4/0.3 mm, moved from (152.72, 86.09) to
    (152.69, 85.95).
    - It sits in a 0.805 mm gap between the WSON pin column and C6
    pad 2. A 0.45 mm via plus two 0.2 mm clearances needs 0.85 mm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
    [PCB v2.kicad_pcb]
